snakescb/TeachZ80/Hardware/Schematic_TeachZ80_V1_2.pdf

## Z80 Family Chips

## Reset

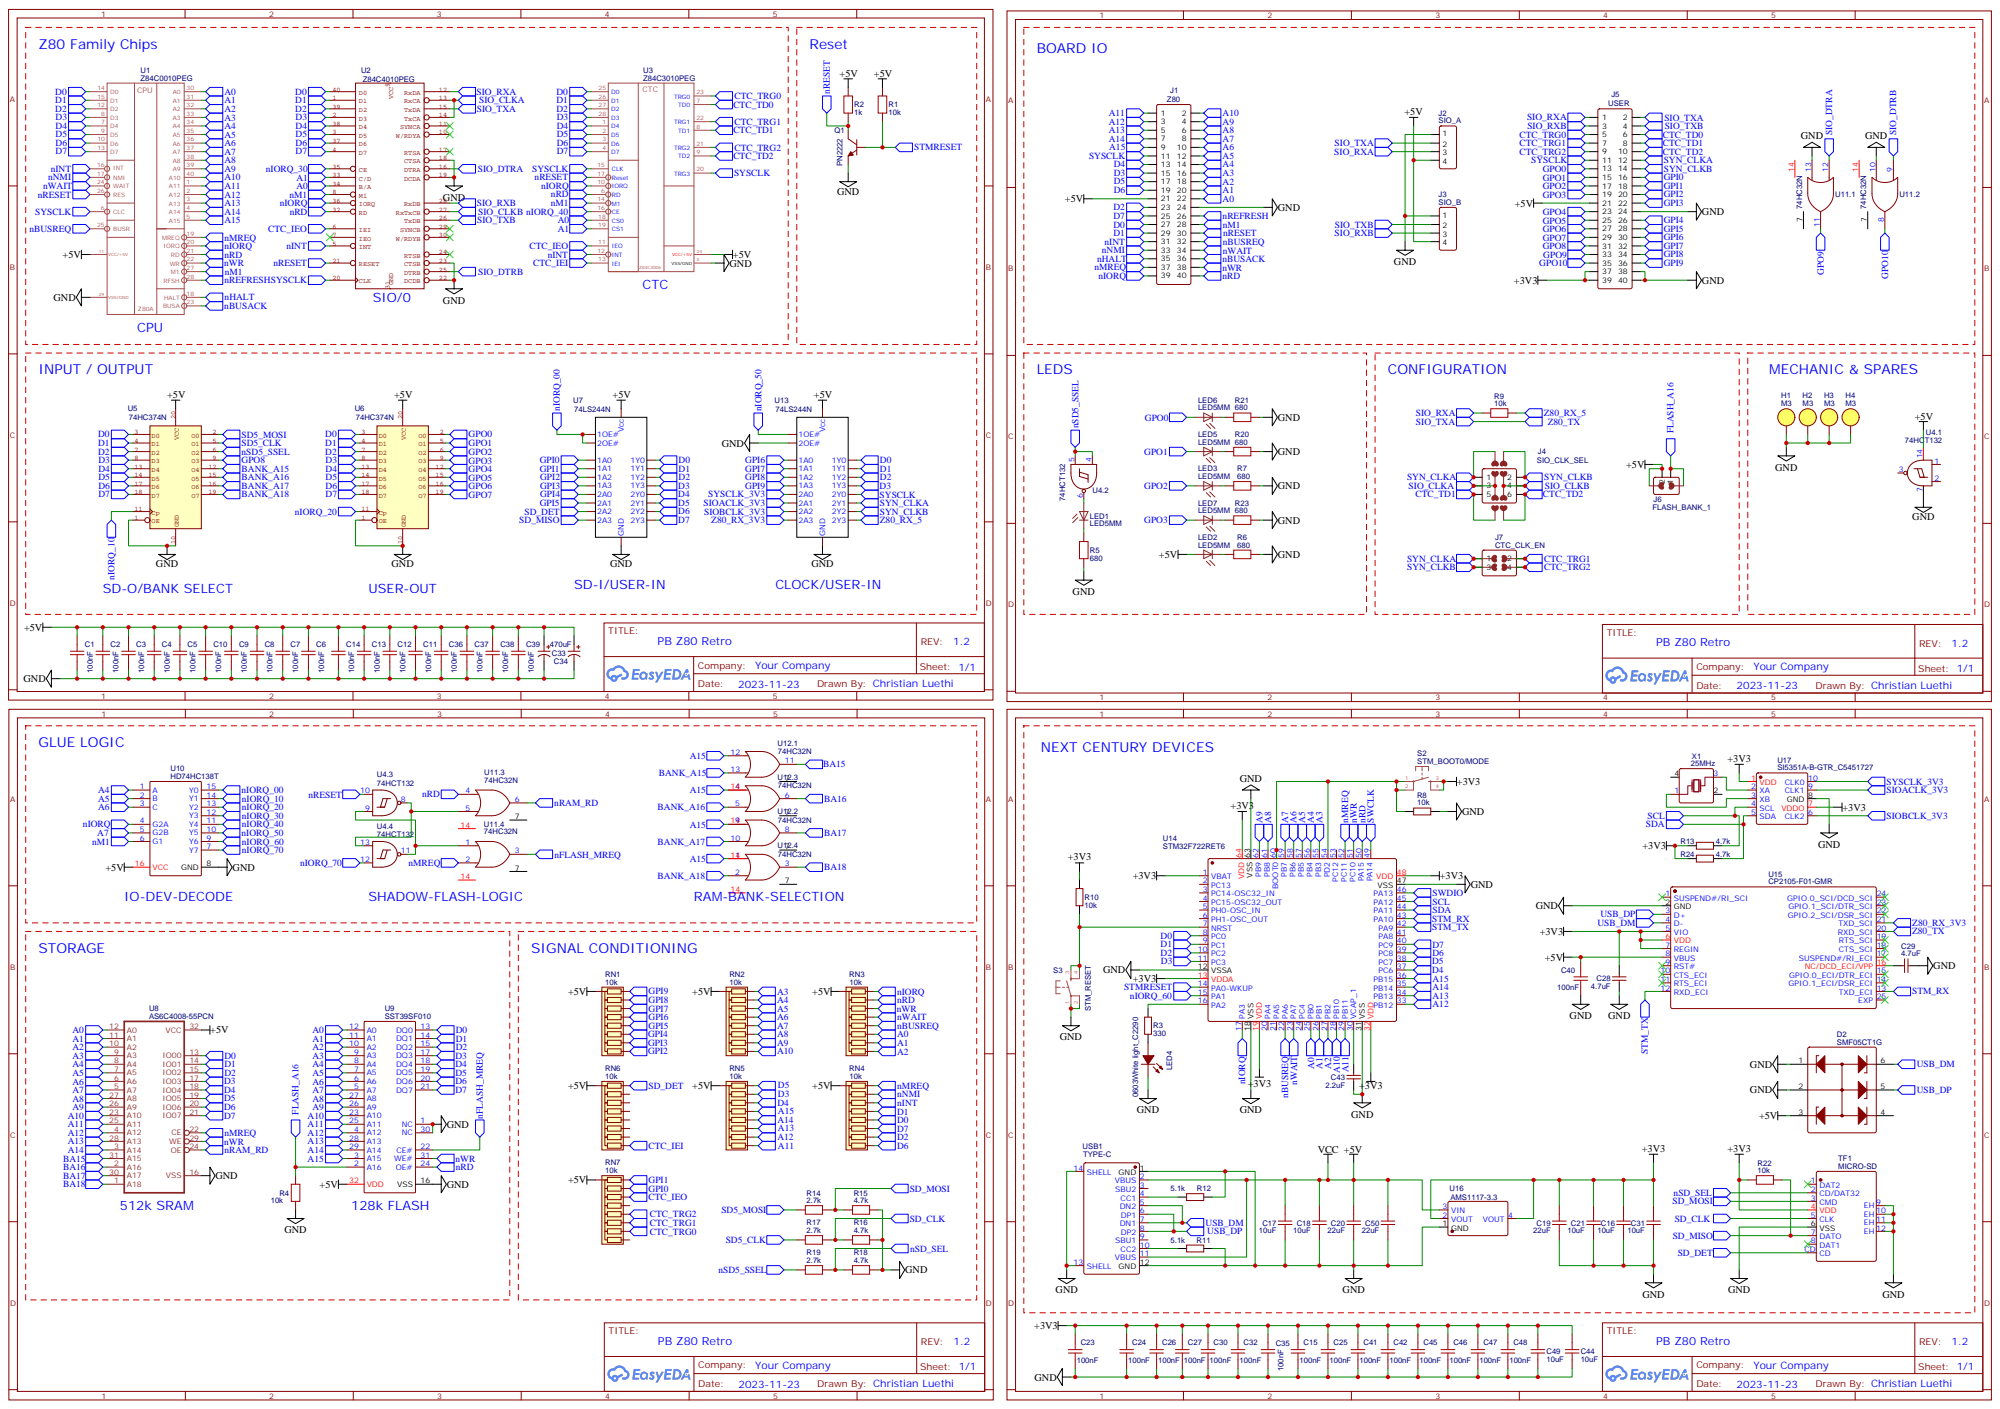
[picture p1: page 1]

Drawn By: Christian Luethi
