snakescb/TeachZ80/Software/stm32/include/Z80Programs.h

#ifndef Z80__PROGRAM
#define Z80__PROGRAM

#include <Arduino.h>

struct z80Program_t {
     const char* name;
     const uint16_t length;
     const uint8_t* data;
};

const uint8_t blinkFlash[] {
     0x21, 0x00, 0x00, 0x3E, 0x00, 0xD3, 0x10, 0x3E, 0x01, 0xD3, 0x20, 0x2B, 0x7C, 0xB5, 0xC2, 0x0B, 
     0x00, 0x3E, 0x04, 0xD3, 0x10, 0x2B, 0x7C, 0xB5, 0xC2, 0x15, 0x00, 0x3E, 0x00, 0xD3, 0x10, 0x3E, 
     0x02, 0xD3, 0x20, 0x2B, 0x7C, 0xB5, 0xC2, 0x23, 0x00, 0x3E, 0x04, 0xD3, 0x10, 0x2B, 0x7C, 0xB5, 
     0xC2, 0x2D, 0x00, 0x3E, 0x00, 0xD3, 0x10, 0x3E, 0x04, 0xD3, 0x20, 0x2B, 0x7C, 0xB5, 0xC2, 0x3B, 
     0x00, 0x3E, 0x04, 0xD3, 0x10, 0x2B, 0x7C, 0xB5, 0xC2, 0x45, 0x00, 0x3E, 0x00, 0xD3, 0x10, 0x3E, 
     0x08, 0xD3, 0x20, 0x2B, 0x7C, 0xB5, 0xC2, 0x53, 0x00, 0x3E, 0x04, 0xD3, 0x10, 0x2B, 0x7C, 0xB5, 
     0xC2, 0x5D, 0x00, 0xC3, 0x03, 0x00, 0x21, 0x00, 0x00, 0x2B, 0x7C, 0xB5, 0xC2, 0x69, 0x00, 0xC9
};

const uint8_t blinkRam[] {
     0x3E, 0x00, 0xD3, 0x10, 0x3E, 0x01, 0xD3, 0x20, 0x21, 0x00, 0x00, 0x11, 0x00, 0x00, 0x01, 0x82, 
     0x00, 0xED, 0xB0, 0xDB, 0x70, 0x31, 0x00, 0x00, 0x06, 0x0A, 0xCD, 0x61, 0x00, 0xCD, 0x6B, 0x00, 
     0xCD, 0x61, 0x00, 0xCD, 0x70, 0x00, 0x3A, 0x7F, 0x00, 0xE6, 0x01, 0xCA, 0x45, 0x00, 0x3A, 0x80, 
     0x00, 0xCB, 0x1F, 0xE6, 0x0F, 0xCA, 0x3B, 0x00, 0xC3, 0x59, 0x00, 0x3E, 0x00, 0x32, 0x7F, 0x00, 
     0x3E, 0x02, 0xC3, 0x59, 0x00, 0x3A, 0x80, 0x00, 0xCB, 0x17, 0xE6, 0x0F, 0xCA, 0x52, 0x00, 0xC3, 
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
     { "SIO - Serial Port test program (115200 8N1)", 586, serialPolled },
     { "BOOT V1.1 - Load Z80 OS from SD Card", 2244, boot_v11 }
};

const z80Program_t z80SDPrograms[] = {
     { "HELLO - Simple Blink loaded from SD card", 615, hellosd }
};


#endif
