snakescb/TeachZ80/Software/stm32/include/Version.h

/* -------------------------------------------------------------------------------------------------------
 Software Version
 
 Author: Christian Luethi
--------------------------------------------------------------------------------------------------------- */

#ifndef VERSION_H
#define VERSION_H

    #define VERSION_MAJOR   1
    #define VERSION_MINOR   0

#endif
