snakescb/TeachZ80/(commit log)

2023-12-13 FlashLoader fixed to work with RaspberryPi
2023-12-26 stm32 last version for V1.0 board (stm32L433)
2023-12-30 SD Driver improvements, Flash Bank Erase Feature
